Galvant/usb_wrapper-pcb/usb_wrapper.pdf

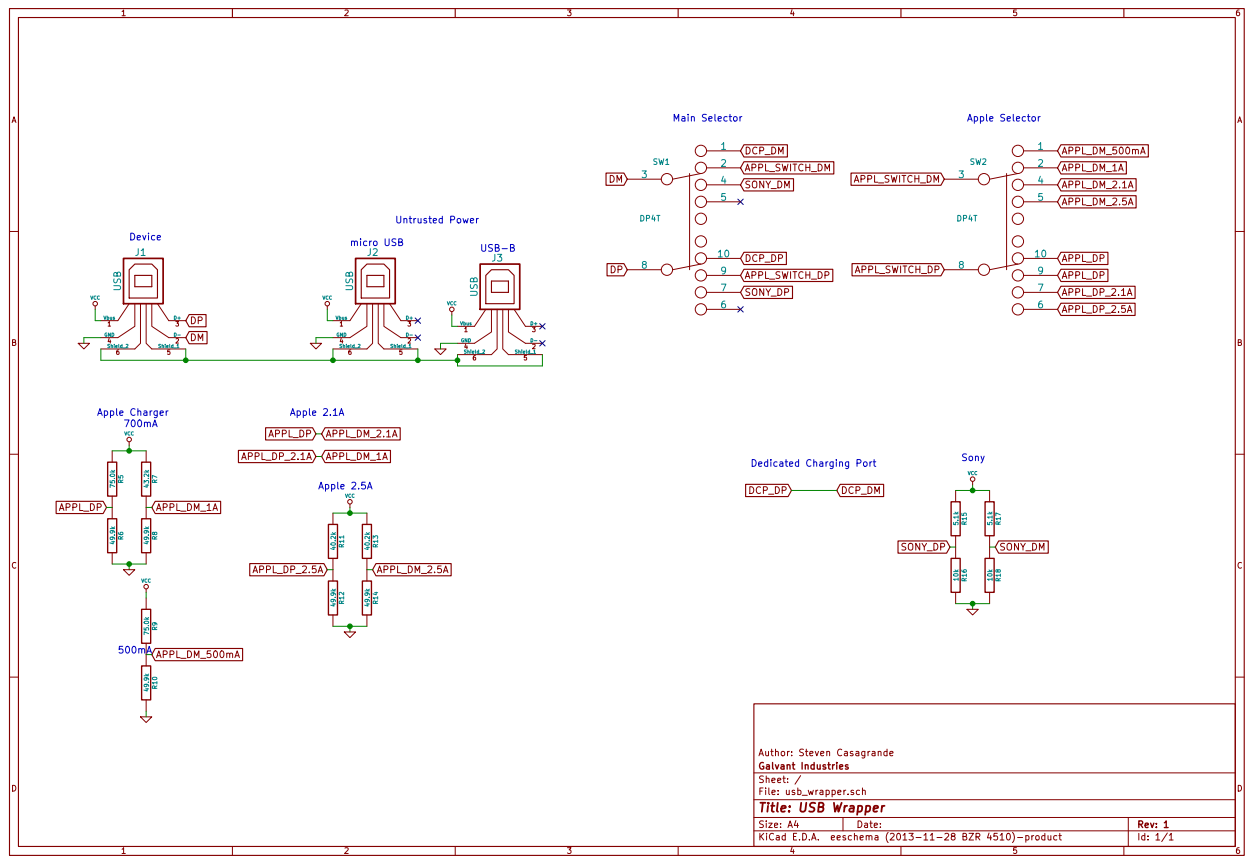
[picture p1: page 1]

File: usb_wrapper.sch Sheet: / Galvant Industries Author: Steven Casagrande

Id: 1/1 Title: USB Wrapper
