Galvant/usb_wrapper-pcb/(commit log)

2014-01-15 Added dp6t switch to schematic
    [usb_wrapper.sch]
2014-01-15 Annotated components and generated netlist
    [usb_wrapper.sch]
2014-01-15 Created empty layout file
    [usb_wrapper.kicad_pcb]
2014-01-16 Added parts to layout
    [usb_wrapper.kicad_pcb, usb_wrapper.sch]
2014-01-16 Basic resistor wiring to the switch
    [usb_wrapper.kicad_pcb]
2014-01-16 Added usb-b to schema for power side
    [usb_wrapper.sch]
2014-01-16 Added open-project kicad lib
2014-01-16 Moved all parts to the top side
    [usb_wrapper.kicad_pcb]
2014-01-16 Split apple off to separate switch
    [usb_wrapper.kicad_pcb, usb_wrapper.sch]
2014-01-16 Reduced PCB width
    [usb_wrapper.kicad_pcb]
2014-01-16 Added oshw logo and rev info
    [usb_wrapper.kicad_pcb]
2014-01-18 Moved resistor value indicators
    [usb_wrapper.kicad_pcb]
2014-01-18 Connected USB shields together
    [usb_wrapper.kicad_pcb, usb_wrapper.sch]
2014-01-18 Generated gerbers and drill files
    [usb_wrapper-B_Cu.gbl, usb_wrapper-B_Mask.gbs, usb_wrapper-B_SilkS.gbo, usb_wrapper-Edge_Cuts.gbr, usb_wrapper-F_Cu.gtl, usb_wrapper-F_Mask.gts, usb_wrapper-F_SilkS.gto, usb_wrapper.drl]
2014-03-24 Added PDF and paste gerber
    [usb_wrapper-F_Paste.gtp]
2014-03-24 Reduced board size slightly
    [usb_wrapper-B_Cu.gbl, usb_wrapper-B_Mask.gbs, usb_wrapper-B_SilkS.gbo, usb_wrapper-Edge_Cuts.gbr, usb_wrapper-F_Cu.gtl, usb_wrapper-F_Mask.gts, usb_wrapper-F_Paste.gtp, usb_wrapper-F_SilkS.gto]
2014-06-03 Generated gerbers for rev1.1
    [usb_wrapper-B_Cu.gbl, usb_wrapper-B_Mask.gbs, usb_wrapper-B_SilkS.gbo, usb_wrapper-Edge_Cuts.gbr, usb_wrapper-F_Cu.gtl, usb_wrapper-F_Mask.gts, usb_wrapper-F_Paste.gtp, usb_wrapper-F_SilkS.gto]
2014-09-12 Fix for incorrect micro-usb pinout
    [usb_wrapper-B_Cu.gbl, usb_wrapper-B_Mask.gbs, usb_wrapper-B_SilkS.gbo, usb_wrapper-Edge_Cuts.gbr, usb_wrapper-F_Cu.gtl, usb_wrapper-F_Mask.gts, usb_wrapper-F_Paste.gtp, usb_wrapper-F_SilkS.gto]
